habonissa/BarrierOperantTasks/Wiring diagram and materials/MaterialsOperantChamber.xlsx

Item | Purpose | Link/info | Additional notes?
1/4" acrylic | For outer portions of cage | https://www.amazon.com/gp/product/B01N0NL2SY/ref=ppx_yo_dt_b_search_asin_title?ie=UTF8&psc=1
1/8" acrylic | For cage barrier | I got this at NYU Tandon Makerspace (in person)
Glass connector | To bind outer portions of cage | https://www.amazon.com/gp/product/B08VD6253K/ref=ppx_yo_dt_b_asin_title_o08_s00?ie=UTF8&psc=1
Stainless steel rods | Tracks for door | https://www.amazon.com/gp/product/B085L7LWXY/ref=ppx_yo_dt_b_asin_title_o09_s00?ie=UTF8&psc=1
Stepper motors | To drive door movement | https://www.amazon.com/gp/product/B01CP18J4A/ref=ppx_yo_dt_b_search_asin_title?ie=UTF8&psc=1
Capacative touch breakout | Nose poke sensor | Found some around lab, Digi-Key is a good source: https://www.digikey.com/en/products/detail/sparkfun-electronics/SEN-14520/8276739 | Another source: https://learn.sparkfun.com/tutorials/at42qt101x-capacitive-touch-breakout-hookup-guide
Arduino | Take capacative touch inputs + drive doors | https://www.amazon.com/gp/product/B007R9TUJE/ref=ppx_yo_dt_b_search_asin_title?ie=UTF8&psc=1
Breadboards | Interface between arduino/tech | https://www.amazon.com/gp/product/B07DL13RZH/ref=ppx_yo_dt_b_search_asin_title?ie=UTF8&psc=1
Jumper cables | Connextions between arduino/tech | https://www.amazon.com/gp/product/B01EV70C78/ref=ppx_yo_dt_b_search_asin_title?ie=UTF8&psc=1
Various screws | No specific suggestions
Cage bottom | N/A, Can be anything to place glass part of cage on. Should be easy to clean for bedding, etc
