habonissa/BarrierOperantTasks/3D print files/Door.stl

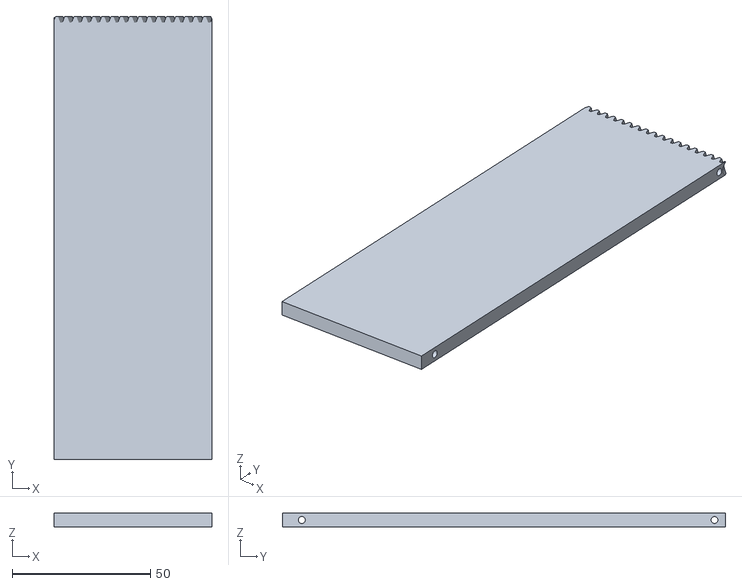
[picture p1: CAD file, 2022-10-25]
3D print files/Door.stl
57.1 x 160.3 x 5.00
