habonissa/BarrierOperantTasks/3D print files/Gear.stl

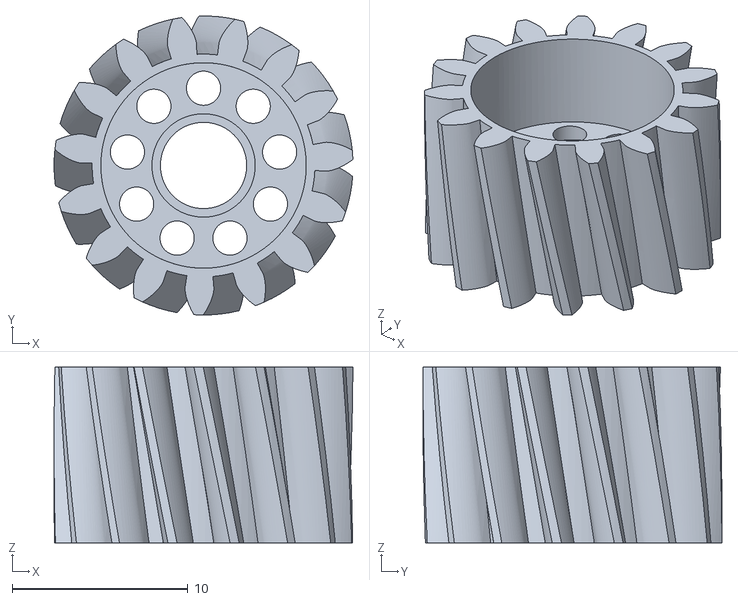
[picture p2: CAD file, 2022-10-25]
3D print files/Gear.stl
17.0 x 17.0 x 10.0
