habonissa/BarrierOperantTasks/3D print files/RodHolder.stl

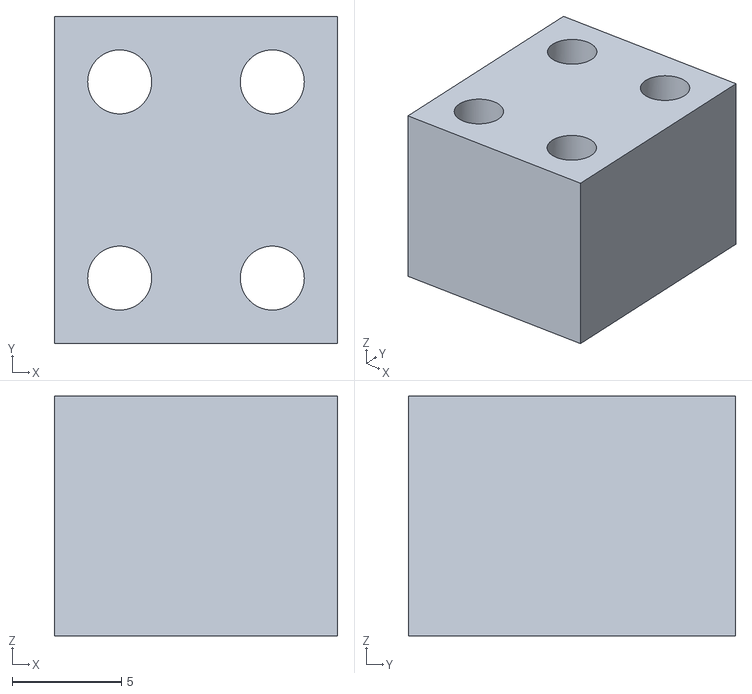
[picture p3: CAD file, 2022-10-25]
3D print files/RodHolder.stl
13.0 x 15.0 x 11.0
