habonissa/BarrierOperantTasks/(list of files, cad)

Other CAD files:
3D print files/Gear.scad
3D print files/RodHolder.scad
