habonissa/BarrierOperantTasks/Wiring diagram and materials/Wiring diagram plain.pdf

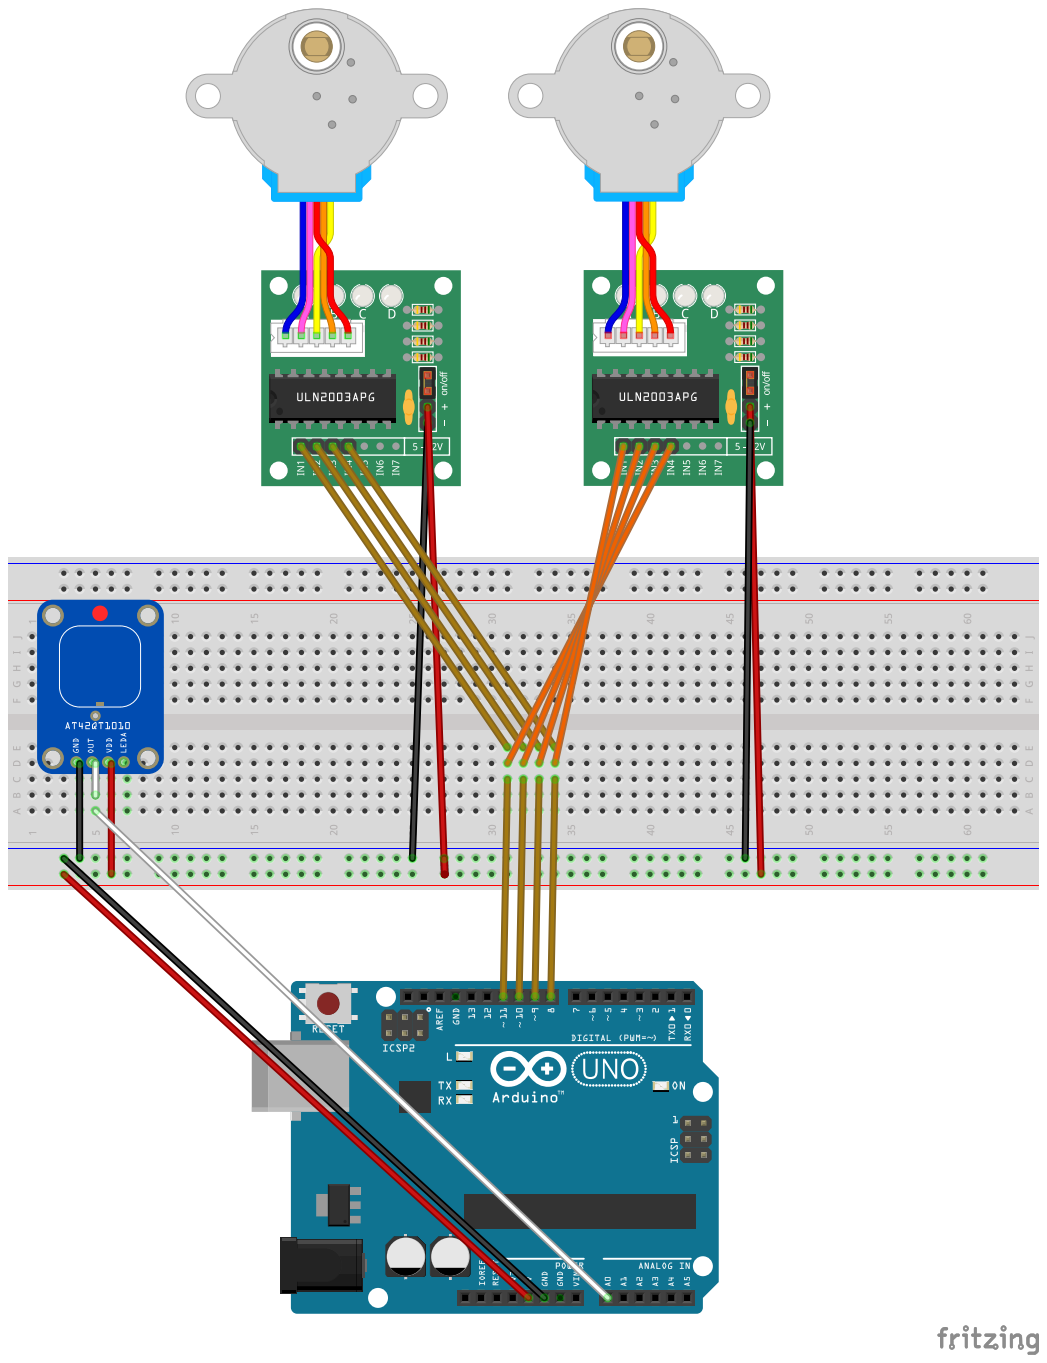
[picture p4: page 1]
