habonissa/BarrierOperantTasks/(list of files, drawings)

Other design files:
Wiring diagram and materials/Wiring diagram.fzz
